fedekau/butia_i2c/doc/programadores/icd2/pinout_ICD2.ods

Nº de pin | Nombre del pin | Color del cable
1 | Vpp | Blanco
32 | Vdd | Negro
12 | Vss | Rojo
40 | PGD | Verde
39 | PGC | Amarillo
- | - | Azul
