fedekau/butia_i2c/doc/programadores/icd2/usb4all-color-cable.pdf

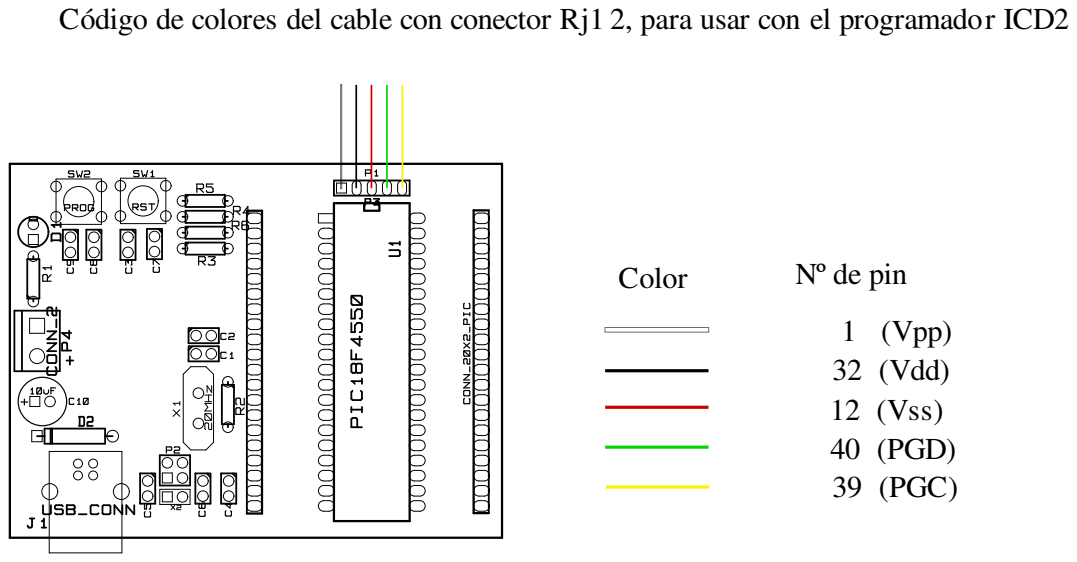
[picture p1: page 1]
Color; Nº de pin; 1 (Vpp) 32 (Vdd) 12 (Vss) 40 (PGD) 39 (PGC)

Código de colores del cable con conector Rj1 2, para usar con el programador ICD2
