fedekau/butia_i2c/pcb/Sharp/sharp.sch

## KiCad design pcb/Sharp/sharp.sch (2012-11-15)

Schematic: sharp.sch

Parts:
J1: RJ45
K1: CONN_3
R2: R
