fedekau/butia_i2c/pcb/sensor_IR/sensor_ir.sch

## KiCad design pcb/sensor_IR/sensor_ir.sch (2013-11-10)


Parts:
D1: LED
J1: RJ45
PHD1: PHOTO_DETECTOR
R1: 4K7
R2: 390R
R3: 1M
U1: LM358N

Connections:
AN: J1.6, R3.2, U1.1
GND: D1.2 (K), J1.5, PHD1.1 (A), U1.3 (+), U1.4 (V-)
LED: D1.1 (A), R2.2
PHD: PHD1.2 (K), R3.1, U1.2 (-)
Vcc: J1.3, R1.1, R2.1, U1.8 (V+)
idAN: J1.4, R1.2
