fedekau/butia_i2c/firmware/u4a2/user/pnp.h

/*******************************************************************************/
#ifndef PNP__H
#define PNP__H

#include "typedefs.h"
#include "user/usb4butia.h"
#include "system/typedefs.h"
#include "user/adminModule.h"
#include "user/loaderModule.h"
/*******************************************************************************/

/*Sensors*/
#define R_PORT_MIN 0
#define R_PORT_MAX 255
#define R_BOTON_MIN 31207
#define R_BOTON_MAX 34492
#define R_GREY_MIN 59041
#define R_GREY_MAX 60124
#define R_DIST_MIN 37491
#define R_DIST_MAX 40654
#define R_LIGHT_MIN 7728
#define R_LIGHT_MAX 9204
#define R_VOLT_MIN 24730
#define R_VOLT_MAX 27887
#define R_RES_MIN 19162
#define R_RES_MAX 21992
#define R_LED_MAX 1815
#define R_LED_MIN 1493
#define R_TEMP_MAX 59147
#define R_TEMP_MIN 57893
//generic sensors
#define R_MOD_SEN_A_MAX 57740
#define R_MOD_SEN_A_MIN 56253
#define R_MOD_SEN_B_MAX 54704
#define R_MOD_SEN_B_MIN 52766
#define R_MOD_SEN_C_MAX 48509
#define R_MOD_SEN_C_MIN 45861
//generic actuators
#define R_MOD_ACT_A_MAX 6554
#define R_MOD_ACT_A_MIN 5461
#define R_MOD_ACT_B_MAX 4520
#define R_MOD_ACT_B_MIN 3745
#define R_MOD_ACT_C_MAX 3151
#define R_MOD_ACT_C_MIN 2601


#define R_MOD_RELAY_MAX 5554 // 120K
#define R_MOD_RELAY_MIN 4615


//#define R_SHIELD_CC_MAX 12531
//#define R_SHIELD_CC_MIN 10622
//#define R_GPIO_MIN 65280
//#define R_GPIO_MAX 65535

#define R_ACCELEROMETER 9999
#define R_PRECION
#define R_MAGNETIC 9999
#define R_MICROPHONE 9999
#define R_TILT 9999
#define R_VIBRATION 9999
#define R_POTENTIOMETER 9999
#define R_CAMERA 9999
#define R_MOTION 9999
#define R_DCMOTOR 9999



#define MAX_DEVICES (byte) 14 /*Max cant of senssor/actuator type*/
/*TODO review this time, the micro is running @20MHZ with a pipeline of 4steps => 20000000/4 = 5000000 instructions per second */
#define PNP_DETECTION_TIME 20000
/** ESTRUCTURES **/

typedef struct _device_resistance {
    byte name[8]; /*name of the string*/
    WORD resValue_min; /*5v = 1023*/
    WORD resValue_max; /*5v = 1023*/
} device_resistance;

typedef struct _port_device_detected {
    int a;

} port_device_detected;

extern byte detected_device_type_id[];

/*Remember to change the old maping for that*/
extern rom const device_resistance table_device_id_resistance[];

#define PNP_MINOR_VERSION 0x01
#define PNP_MAJOR_VERSION 0x00

typedef union PNP_PACKET {
    byte _byte[USBGEN_EP_SIZE]; //For byte access
    word _word[USBGEN_EP_SIZE / 2]; //For word access(USBGEN_EP_SIZE msut be even)

    struct {

        enum {
            READ_VERSION = 0x00,
            GET_RES = 0x01
        } CMD;
        byte len;
    };

    struct {
        unsigned : 8;
        byte ID;
    };

    struct {
        unsigned : 8;
        byte higth;
        byte low;
    };

    struct {
        unsigned : 8;
        word word_data;
    };
} PNP_DATA_PACKET;


/** FUNCTIONS ****/
void PNPInit(byte handler);
void hotplug_pnp(void);
void openPnP(byte moduleId[8], byte handler);



#endif //PNP__H
