fedekau/butia_i2c/(commit log)

2011-07-23 INITIAL COMMIT!!! (V2 usb4all from svn@23/07/2011)
    [pinout_ICD2.ods, shield_usb4all.brd, shield_usb4all.sch, shield_usb4all_nuevo.brd, shield_usb4all_ori.brd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]
2011-07-31 adding fsusb util for uploading firmware to the usb4all board
2011-08-06 modulo de testeo para shield butia usb4all
2012-03-28 Fixed somes compling errors
    [adminModule.c, adminModule.h, handlerManager.c]
2012-04-13 Implementation for Analogic reading Detection pin, usb4butia.c was created
2012-04-16 Add sensorType definition, sensorTable and function initSensorTable
2012-04-16 IN hotplug&play fixed get_device_type, now send the correct parameter to this function
    [adminModule.c]
2012-04-17 Add PnP archive, start implement tabe with resistance values
2012-04-18 Replace old table for table_device_id_resistance_value, and add xlm for proyect
    [adminModule.c, pnp.h]
2012-04-19 Fix some compling error... is not compling yet
    [adminModule.c, pnp.c, pnp.h, usb4butia.c]
2012-04-19 Fixed more compiling erros, now is compiling
    [pnp.c, pnp.h]
2012-04-20 Add module for test resistance values in port 1
2012-04-20 Still fixing error, still compile
    [usb4butia.c, usb4butia.h]
2012-04-20 Fix ldr location
    [ldr.brd]
2012-04-20 Finish Sharp Module sensor
    [sharp.brd, sharp.sch]
2012-04-21 Change dicrection and add pull up for AX12 conector, v1.6
    [usb4butia.brd, usb4butia.sch]
2012-04-21 changed prototype of received functions
2012-04-24 added led user module.
2012-04-25 Test resistance it's working need somes adjusts
2012-04-25 Reimplemeted getDeviceType function and are real resistance value in table
2012-04-25 Added PCBs for usb4butia and sensors
    [PCB_Sensores_Lego.brd, Sensores 2.0.brd, Sensores 2.0.sch, Sensores_Generico_Lego.brd, probut5x.brd, probut5x.sch, probut6-3.brd, probut6-3.sch]
2012-05-01 test case needed
2012-05-04 with timeout in readserial the board lost comunication with the PC maybe because setRX disables trasmition. So I disable the TIMEOUT check. Now is working ok, the only issue is that the first 3 calls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
    [ax12.c]
2012-05-05 Fixed compiling error, now is compiling
    [pnp.c, pnp.h, port.c, port.h]
2012-05-07 more consise return ERROR
    [loaderModule.c]
2012-05-07 fix hardcode of pnp module
    [adminModule.c, handlerManager.c, pnp.c]
2012-05-08 added consistency with drivers of user modules. Minnor changes
2012-05-15 Add sensors modules
    [Sensores_Generico_Lego.brd, Sharp.brd, boton.brd, boton.sch, boton_Plantilla.brd, ldr.brd, ldr.sch]
2012-05-22 sharp sensor with GND cape
    [sharp.brd]
2012-05-23 Delet pull up from sharp sensor, shapr v1.7
    [sharp.brd, sharp.sch]
2012-05-23 Set Resistance value in ldr sensor
    [ldr.brd, ldr.sch]
2012-05-23 Rename somes islets in ldr pcb
    [ldr.brd]
2012-05-24 Add .lib in ldr sensor
2012-05-24 Change Holders names
    [boton.brd]
2012-05-24 Fix error in net file of sharp sensor
2012-05-24 Change design sharp, v1.8
    [sharp.brd]
2012-05-28 translated sensors name in the devide id resistance table
2012-05-31 Add Bridge as componets
    [usb4butia.brd]
2012-06-05 USB4butia v1.7.1
    [usb4butia.brd]
2012-06-05 USB5butia 1.7.2
    [usb4butia.brd]
2012-06-06 usb4butia 1.7.3
    [usb4butia.brd]
2012-06-07 Formalizate Bridges definition usb4butia1.7.3
    [usb4butia.sch]
2012-06-07 switch to bootloader command added to fsusb utility with --bootloader command
2012-06-08 Still working in usb4buti 1.7.4
    [usb4butia.brd, usb4butia.sch]
2012-06-08 usb4butia1.7.5 prototipe completed
    [usb4butia.brd]
2012-06-11 usb4butia1.8 have bornier for switch
    [usb4butia.brd, usb4butia.sch]
2012-06-14 changes in motores.c
2012-06-20 Fix somes bridge problems and replce jack connector usb4butia 1.8.1
    [usb4butia.brd, usb4butia.sch]
2012-06-20 Add PCB_Edges cape in LDR
    [ldr.brd]
2012-06-20 Add PCB_Edges cape sharp
    [sharp.brd]
2012-06-20 Add PCB_Edges cape boton
    [boton.brd]
2012-06-20 Add silkscreen usb4butia1.8.1
    [usb4butia.brd]
2012-06-20 Change name in PCB to Module Button
    [boton.brd]
2012-06-21 New version botton PBC compatible with 5x5mm connector
    [boton.brd, boton.sch]
2012-06-21 first version of autodetection wheels working
2012-06-21 Reduce the large of the pcb usb4butia1.8.2
    [usb4butia.brd]
2012-06-22 PCB size readuced usb4butia1.8.3
    [usb4butia.brd]
2012-06-22 Move holder islet usb4butia1.8.4
    [usb4butia.brd]
2012-06-26 Added in copper cape Fabricado por Eneka
    [boton.brd]
2012-06-26 Added Fabricado por Eneka module sharp
    [sharp.brd]
2012-06-26 Added Fabricado por Eneka module LDR
    [ldr.brd]
2012-06-26 Added Fabricado por Eneka usb4butia1.8.4
    [usb4butia.brd]
2012-06-26 Fix text spell in module botton
    [boton.brd]
2012-07-08 There is no reason to port B start as digital after microcontroller reset as we are using all the pins as analog
    [main.c]
2012-07-08 adding changes for flashing without pressing the programming button in git butia to git usb4all
2012-07-08 fixed first_port_read bug :)
    [adminModule.c, handlerManager.h, main.c, pnp.c, pnp.h, port.c, usb4butia.c]
2012-07-09 no root check for flashing the USB4butia board in order to use with fua in OLPC XO distributed by CEIBAL
2012-07-14 slow down readserial TIMEOUT to speed up motor detection
2012-07-14 fixed first_time_read_port bug with ax12 motors disconected. seems to be problem of concurrency
    [ax12.c, main.c]
2012-07-14 this is a biiig problem! fixed..
    [ax12.c]
2012-07-19 added light sensor module
2012-07-19 added new resistance value for light sensor
2012-08-15 fixed bug when making an int from 2 bytes. High byte was nulled :(
    [ax12.c]
2012-09-11 creat new folder for usb4all
    [usb4all.brd, usb4all.sch]
2012-09-11 restruct folders usb4butia
    [PCB_Sensores_Lego.brd, Sensores 2.0.brd, Sensores 2.0.sch, Sensores_Generico_Lego.brd, probut5x.brd, probut5x.sch, probut6-3.brd, probut6-3.sch]
2012-09-11 restruct folders
    [PCB_Sensores_Lego.brd, Sensores 2.0.brd, Sensores 2.0.sch, Sensores_Generico_Lego.brd, probut5x.brd, probut5x.sch, probut6-3.brd, probut6-3.sch]
2012-09-12 get volt
2012-09-13 increment islets button size
    [boton.brd]
2012-09-13 increas sharp and ldr islets size
    [Sharp.brd, ldr.brd, sharp.brd]
2012-09-17 Increase pads size USB4butia v1.8.5
    [usb4butia.brd]
2012-09-19 fix button spell in pbc
    [boton.brd]
2012-10-12 added generic user module to read voltage
2012-10-12 added user module to read resistance values
2012-10-19 Starting Module red_resistance develop
    [lector_recistancia.sch]
2012-10-25 Arreglos en vías para que no se produzcan errores al correr un DRC.
    [usb4butia.brd]
2012-10-30 Change the bridge components for vias
    [usb4butia.brd, usb4butia.sch]
2012-11-06 Added componet Jack to module lector resistencia
2012-11-06 Change names of files and add new component jack audio
    [lector_recistancia.sch]
2012-11-06 Add new component jack audio in schematic and pcb
    [lector_resistencia.brd, lector_resistencia.sch]
2012-11-07 defined resistance min/max for new sensors
2012-11-07 trying new autodetection funtion for motors
2012-11-07 added 22k resistence
    [lector_resistencia.brd, lector_resistencia.sch]
2012-11-08 Add border line and finish v1.0
    [lector_resistencia.brd]
2012-11-08 correction of tracks because DRC release errors
    [lector_resistencia.brd, lector_resistencia.sch]
2012-11-13 Edit size pads and change some tracks
    [lector_resistencia.brd, lector_resistencia.sch]
2012-11-14 deleted warning in config prototype function from modules
2012-11-14 deleting prototype definitions and pointers warnings
2012-11-15 changed volt name
2012-11-15 Add connector for pins RD0 & RD1. Add jumper for power supply motors
    [usb4butia.brd, usb4butia.sch]
2012-11-20 Add new layer and edit pad drill
    [usb4butia.brd]
2012-11-21 Add module led
2012-11-23 Add butia's logo in front layer
    [usb4butia.brd]
2012-11-28 Add schematic H bridge for DC motors
    [puenteH.sch]
2012-12-07 Add holes for hold
    [usb4butia.brd]
2012-12-11 Add optos for digital signals
    [puenteH.sch]
2012-12-14 Add pins for interface between the H bridge and the uC
    [puenteH.sch]
2012-12-18 Add table of true
    [puenteH.sch]
2012-12-20 fix little bug when open pnp module
    [pnp.c]
2012-12-21 Cocumentation hackpoints
    [usb4butia.brd]
2012-12-21 Complete table of true
    [puenteH.sch]
2012-12-26 Relay module
    [Relay.brd, Relay.sch, Relay_motor.sch]
2013-01-16 Add voltage PCB desing and modified PCB resistance desing
    [lector_voltaje.brd]
2013-01-25 fixed loopback user module
    [userLoopBack.c, userLoopBack.h]
2013-01-30 fixing silk
    [usb4butia.brd]
2013-01-30 template for sensors
    [$plantilla_allsenAdvance.brd, plantilla_allsen.brd, plantilla_allsenAdvance.brd, plantilla_working2.brd]
2013-02-05 fix warning in usr_motors.c
    [usr_motors.c]
2013-02-06 led only have one TURN function
2013-03-05 More silk fixing
    [usb4butia.brd]
2013-03-05 Add PWM points
    [usb4butia.brd, usb4butia.sch]
2013-03-06 add Desinged in Uruguay and fix a bug
    [usb4butia.brd]
2013-03-06 working in copper logo
    [usb4butia.brd]
2013-03-06 usb4butia1.8.8 with logo
    [usb4butia.brd]
2013-03-07 fix silk things
    [usb4butia.brd]
2013-03-07 Fix more silk errors and add gerber version
    [usb4butia.brd]
2013-03-07 usb4butia1.8.8 release without logo
    [usb4butia.brd]
2013-03-14 added timer1 module
2013-03-18 defined new res to cc motor
2013-03-18 added function to control forw,backw,left,right with cc motors
2013-03-21 Fix problem islet in LDR, add led develop module
    [ldr.brd, led.kicad_pcb, led.sch, plantilla_allsen.brd]
2013-04-04 Add pull ups for pins 15, 16 & 17
    [usb4butia.kicad_pcb, usb4butia.sch]
2013-04-04 Change resistor R15, R16 & R17 from 1K to 10K
    [usb4butia.kicad_pcb, usb4butia.sch]
2013-04-05 Driver for DC motors with L298
    [potl298.kicad_pcb, potl298.sch]
2013-04-13 H bridge L298 completed for connect to usb4butia (version 1.8.9 and futures)
    [potl298.kicad_pcb, potl298.sch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]
2013-04-15 some warnings solved and includes changed
    [handlerManager.c, main.c, pnp.c, usr_ax.c, usr_ax.h]
2013-04-15 added sensors to project to test all functionalities
2013-04-16 fix utab two warnings
    [loaderModule.c]
2013-04-23 fix autodetection for ax12
    [handlerManager.c, usr_motors.c]
2013-04-25 fix a lot of types
    [T0Proxy.c, T0Proxy.h, T0Service.c, T0Service.h, adminModule.c, ax12.c, ax12.h, descriptorManager.h]
2013-04-26 Changing pull ups for pull downs in pins 15, 16 and 17
    [usb4butia.kicad_pcb, usb4butia.sch]
2013-04-29 changing pull down for pull up
    [potl298.drl]
2013-05-02 boton compatibility with sw 12mm version 1.2
    [boton.brd, boton.sch]
2013-05-02 increase drill holders size
    [sharp.brd]
2013-05-02 fix and form update
    [plantilla_allsen.brd]
2013-05-02 Fix silk in ldr module
    [ldr.brd, plantilla_allsen.brd]
2013-05-02 advance form update
    [plantilla_allsenAdvance.brd]
2013-05-03 new module led and somes changes
    [boton.brd, ldr.brd, led.brd, led.sch, plantilla_allsen.brd, plantilla_allsenAdvance.brd, sharp.brd]
2013-05-04 fix uTab missing declaration
    [loaderModule.h]
2013-05-04 motors inverse must be a byte
2013-05-04 motors direction to byte
2013-05-16 fix hacks set mode
    [usr_hackpoints.c]
2013-05-17 Device string descriptors changed
    iManufacturer 1 www.fing.edu.uy/inco/proyectos/butia
    iProduct 2 USB4Butia 2011 FING UdelaR
2013-05-22 First version of infra red barrier
    [barrera_ir.kicad_pcb, barrera_ir.sch]
2013-05-22 change id for cc motors 100
2013-05-23 correction bug in circuit of infra red barrier
    [barrera_ir.kicad_pcb, barrera_ir.sch]
2013-05-30 H bridge with IC L298HN
    [l298hn.kicad_pcb, l298hn.sch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]
2013-06-10 fix sillk in usb4butia
    [usb4butia.brd]
2013-06-10 fix value resistence
    [usb4butia.sch]
2013-06-10 add version 1.9.0 gerbers of usb4butia
2013-06-20 Add pull down in shield motors (pins HK15 and HK16) for compatibility with usb4butia v1.8.8
    [l298hn.kicad_pcb, l298hn.sch]
2013-06-20 Add gerber v1.1 for shield motors
    [l298hn.drl]
2013-06-25 Change the wired AND for wired OR in the output of barrier IR
    [barrera_ir.kicad_pcb, barrera_ir.sch]
2013-07-02 pull down pin Hk 15 and 16 in vertical shield
    [potl298.brd, potl298.kicad_pcb, potl298.sch]
2013-07-23 fix led user module
    [usr_led.c]
2013-07-23 add led user module
2013-07-28 correct lenght of bytes
    [adminModule.c, adminModule.h]
2013-07-28 fix pnp getVersion function
    [pnp.c, pnp.h]
2013-07-30 Sensor IR for measure distance
    [sensor_ir.kicad_pcb, sensor_ir.sch]
2013-08-01 fix loopBack to new style
    [userLoopBack.c]
2013-08-01 more elegant motors calls
2013-08-05 Temperature sensor
    [temperatura.brd, temperatura.sch]
2013-08-05 generic PCB sensor
    [PCB_Sensores_Lego.brd, Sensores 2.0.brd, Sensores_Generico_Lego.brd, Sensores_Generico_Lego_.brd, generico.brd, generico.sch]
2013-08-07 correct tabs in dynamicPolling
    [dynamicPolling.c]
2013-08-07 fix motors type
2013-08-07 fix sense of cc motor function
    [usr_motors.c]
2013-08-18 fix cast to motors type to byte
    [usr_motors.h]
2013-08-18 fix tabs in loaderModule
    [loaderModule.c, loaderModule.h, usr_motors.h]
2013-08-18 more cleans and tabs fixed
    [adminModule.c, adminModule.h]
2013-08-20 add old message function in admin - some tabs fixes
    [T0Service.c, adminModule.c, main.c]
2013-09-04 add generic sensor and actuators
2013-11-09 fixing the memory check error - skip first 64bytes
    [main.c]
2013-11-10 spaces and tabs fixes
    [T0Service.c, ax12.c, descriptorManager.c, handlerManager.c, main.c, pnp.c, port.c, usr_ax.c]
2013-11-10 correct place for usb4all shields
    [shield_usb4all.brd, shield_usb4all.sch, shield_usb4all_nuevo.brd, shield_usb4all_ori.brd, shield_usb4all_san.brd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]
2014-02-12 adding support for CC motors set vel
2014-03-13 fix problem with the support for CC motors set vel
    [usr_motors.c]
2014-05-06 fix error with direction
    [usr_motors.c]
2014-05-29 fixed copy paste error x
    [pnp.c]
2014-07-30 Fix problem with speed
    [usr_motors.c]
2014-08-05 fix speed motors
2014-12-03 Fix problem with sense AX12
    [usr_motors.c]
2015-06-04 add buzzer and relay - remove led and temp
    [pnp.c, pnp.h, usr_modAct.c, usr_modSen.c]
2015-09-04 added firmware 13 relay
2016-11-18 Recibe byte de pc
