fedekau/butia_i2c/(notices)

Notices in the files:
usb4all_kernel_module/usb4all.h:
modify it under the terms of the GNU General Public License as
published by the Free Software Foundation, version 2.
